lucaswjunges/esp32-ws2815-wled/(commit log)

2026-03-31 Initial release — ESP32 + WS2815 12V WLED system
    Complete hardware design for 2 independent ESP32 + WS2815 LED strip
    systems. Corrected from WS2812B@5V (18A) to WS2815@12V (~7.5A):
    - Direct 12V strip connection, no step-down buck for strip
    - Per-system PSU: LRS-150-12 (12.5A)
    - 10A fuse per system
    - Power analysis, SPICE simulation, BOM, wiring diagrams
    [gerar_pdf_bom.py, plot_simulation.py, sketch.ino]
2026-03-31 Fix BOM_Quote: WS2815 corrections + PSU sizing note
    - All WS2812B references removed (5V/18A → 12V/7.5A)
    - Power table now shows per-system values (removes incorrect 15.31A combined total)
    - Fuse corrected: 25A → 10A
    - Cap corrected: 1000µF/10V → 470µF/25V (12V rail requires 25V rating)
    - Power injection: NOT REQUIRED → RECOMMENDED
    - WLED current limit: 9000mA → 6000mA default / 7500mA max for 10A PSU
    - Added PSU sizing note: 10A/220V→12V is acceptable for typical use
    (7.5A is worst-case full white; colorful effects draw 2–4A)
    - Zero LaTeX compilation warnings
